miree/tempLoggerNG/hardware/tempLoggerNG-schematic.pdf

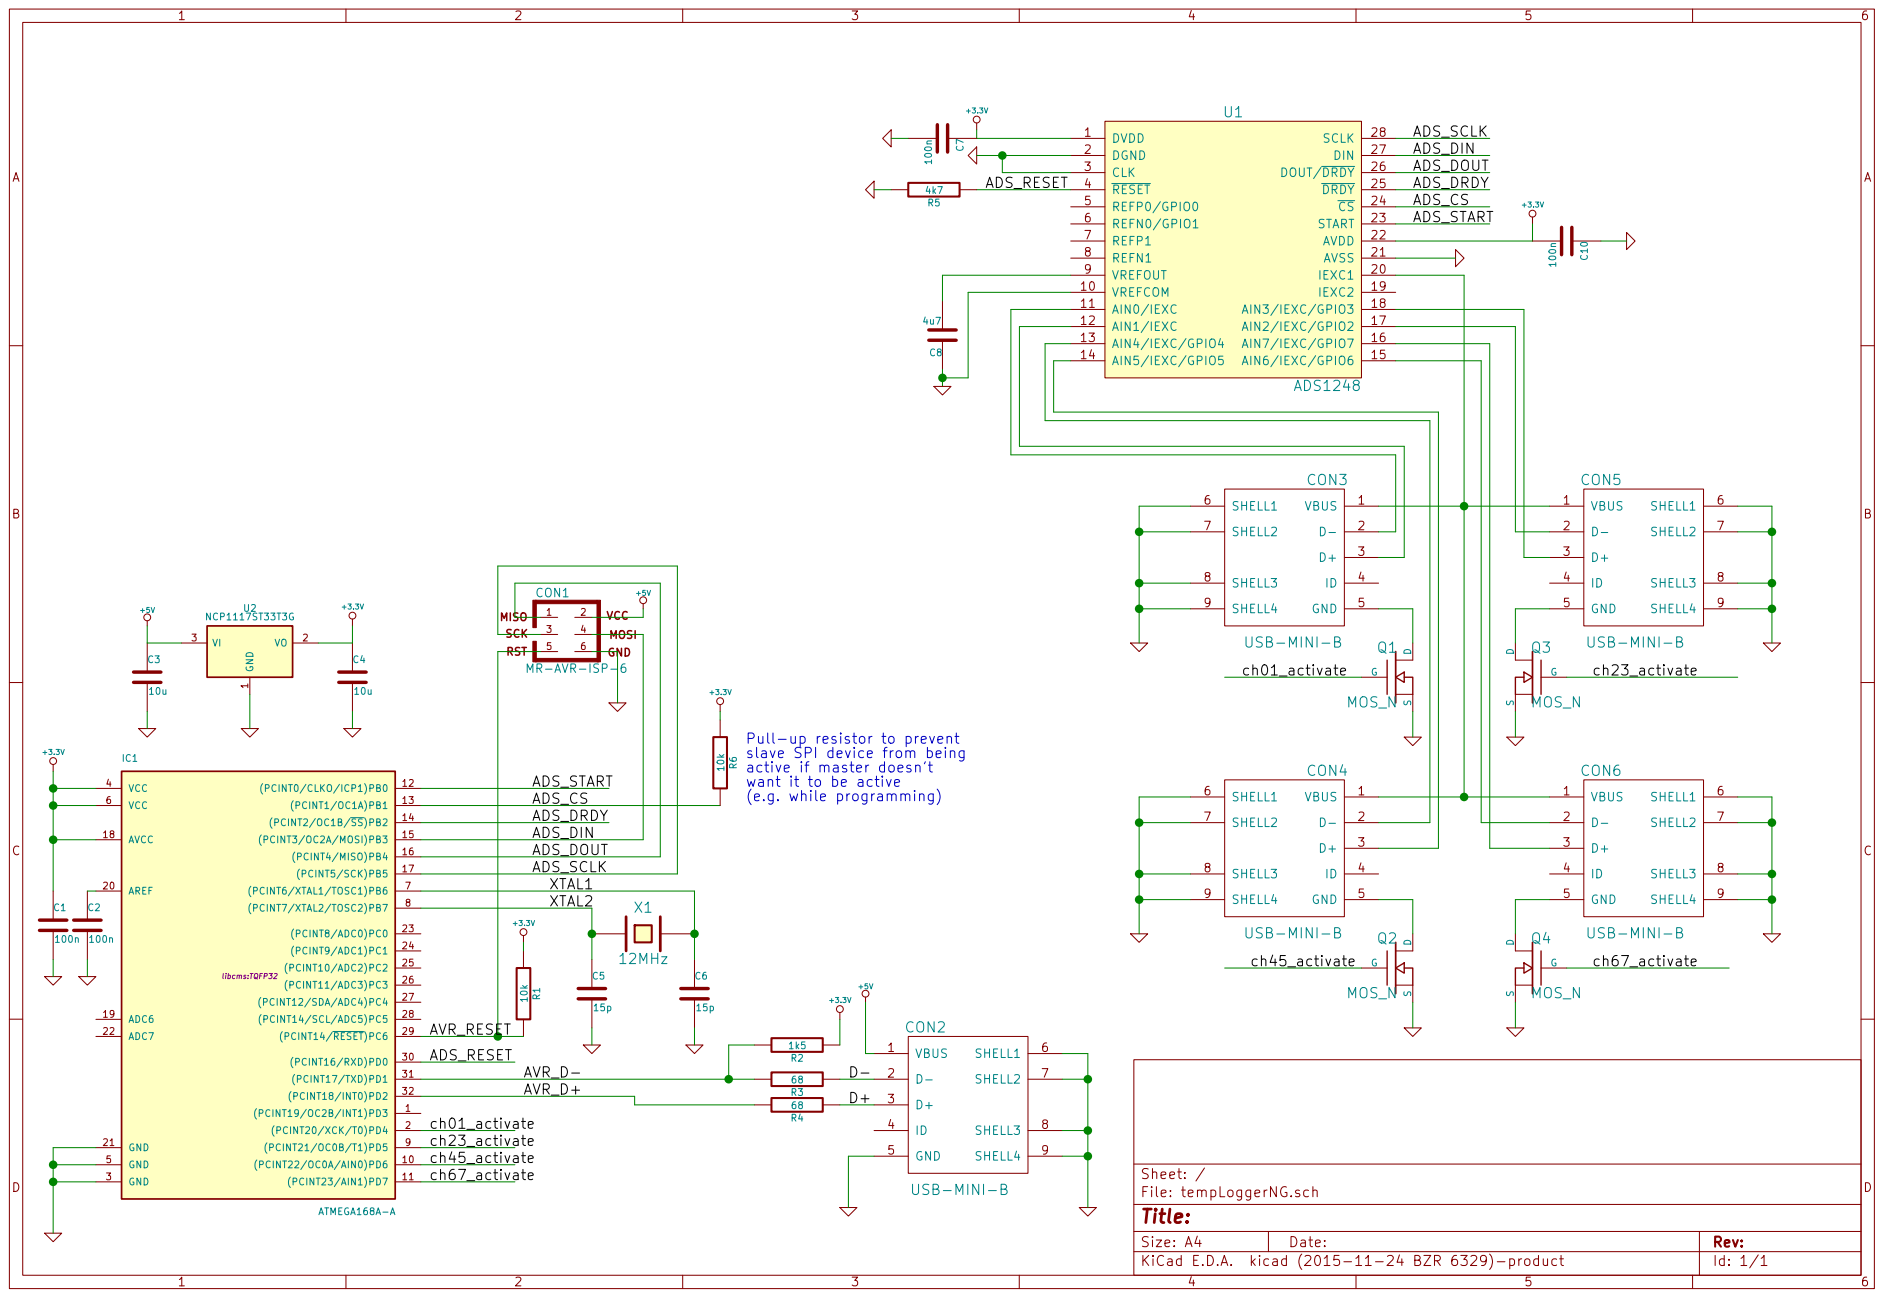
[picture p1: page 1]

slave SPI device from being
active if master doesn't want it to be active (e.g. while programming)

ADS_DRDY
ADS_DIN
ADS_DOUT
ADS_SCLK

File: tempLoggerNG.sch Sheet: /
Id: 1/1 Title:
