miree/tempLoggerNG/(list of files, drawings)

Other design files:
hardware/tempLoggerNG.dsn
