miree/tempLoggerNG/hardware/tempLoggerNG.kicad_pcb

## KiCad design hardware/tempLoggerNG.kicad_pcb (2026-10-11)

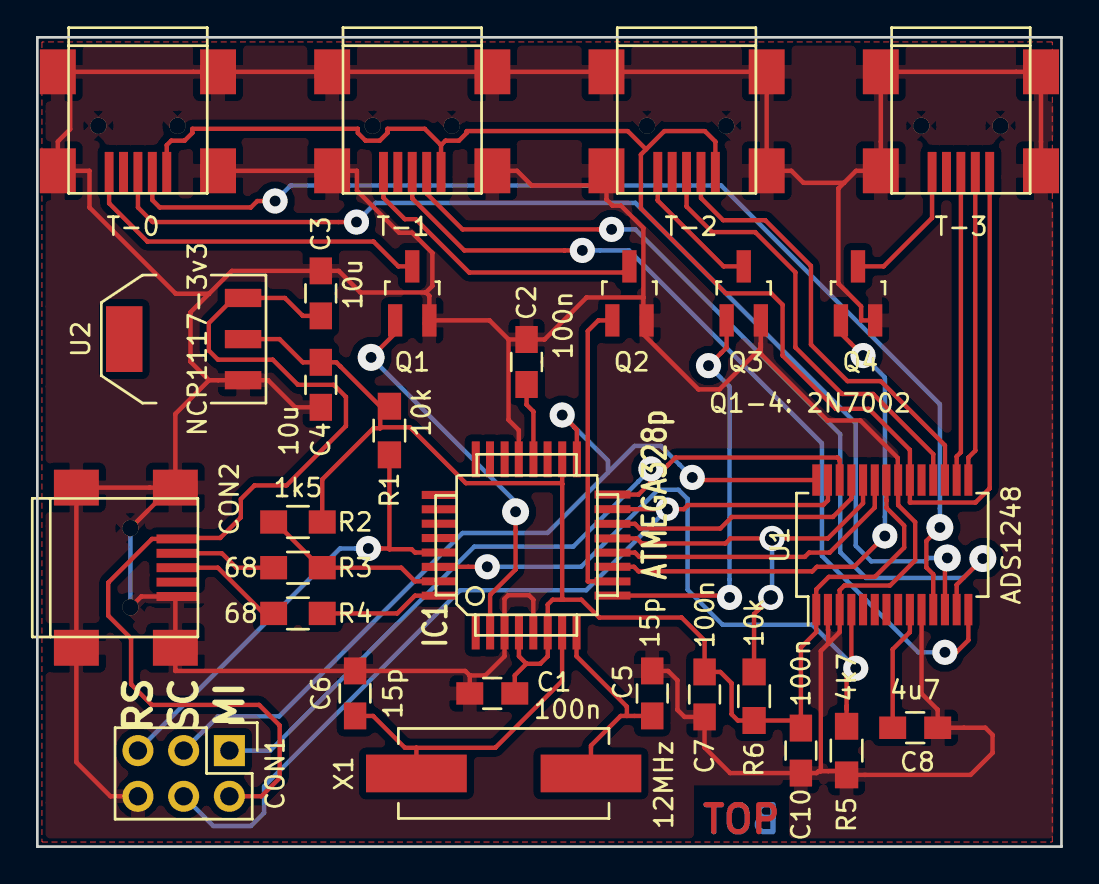
[picture p2: board tempLoggerNG.kicad_pcb from above]

Board: 2 copper layers, 56.9 x 45.0 mm, 29 parts (0 on the bottom side), 36 nets.

Parts:
C1, C2, C7, C10: 100n; C_0805_HandSoldering
C3, C4: 10u; C_0805_HandSoldering
C5, C6: 15p; C_0805_HandSoldering
C8: 4u7; C_0805_HandSoldering
CON1: MR-AVR-ISP-6; Pin_Header_Straight_2x03
CON2: USB-MINI-B; USB_Mini-B
IC1: ATMEGA328p; TQFP32
Q1, Q2, Q3: MOS_N; SOT-23_GSD_Handsoldering
Q4: Q1-4: 2N7002; SOT-23_GSD_Handsoldering
R1, R6: 10k; R_0805_HandSoldering
R2: 1k5; R_0805_HandSoldering
R3, R4: 68; R_0805_HandSoldering
R5: 4k7; R_0805_HandSoldering
T-0, T-1, T-2, T-3: USB-MINI-B; USB_Mini-B
U1: ADS1248; SSOP-28_5.3x10.2mm_Pitch0.65mm
U2: NCP1117-3v3; SOT-223
X1: 12MHz; Crystal_HC49-SD_SMD

Connections:
+3.3V: C1.1, C4.1, C7.1, C10.2, IC1.4, IC1.6, IC1.18, R1.1, R2.1, R6.1, U1.1, U1.22, U2.2
+5V: C3.1, CON1.2, CON2.1, U2.3
/ADS_CS: IC1.13, R6.2, U1.24
/ADS_DIN: CON1.4, IC1.15, U1.27
/ADS_DOUT: CON1.1, IC1.16, U1.26
/ADS_DRDY: IC1.14, U1.25
/ADS_RESET: IC1.30, R5.1, U1.4
/ADS_SCLK: CON1.3, IC1.17, U1.28
/ADS_START: IC1.12, U1.23
/AVR_D+: IC1.32, R4.2
/AVR_D-: IC1.31, R2.2, R3.2
/AVR_RESET: CON1.5, IC1.29, R1.2
/D+: CON2.3, R4.1
/D-: CON2.2, R3.1
/XTAL1: C6.1, IC1.7, X1.2
/XTAL2: C5.1, IC1.8, X1.1
/ch01_activate: IC1.2, Q1.G
/ch23_activate: IC1.9, Q3.G
/ch45_activate: IC1.10, Q2.G
/ch67_activate: IC1.11, Q4.G
GND: C1.2, C2.2, C3.2, C4.2, C5.2, C6.2, C7.2, C8.1, C10.1, CON1.6, CON2.5, CON2.6, CON2.7, CON2.8, CON2.9, IC1.3, IC1.5, IC1.21, Q1.S, Q2.S, Q3.S, Q4.S, R5.2, T-0.6, T-0.7, T-0.8, T-0.9, T-1.6, T-1.7, T-1.8, T-1.9, T-2.6, T-2.7, T-2.8, T-2.9, T-3.6, T-3.7, T-3.8, T-3.9, U1.2, U1.3, U1.10, U1.21, U2.1
unnamed: C2.1, IC1.20
unnamed: C8.2, U1.9
unnamed: T-0.1, T-1.1, T-2.1, T-3.1, U1.20
unnamed: T-0.2, U1.11
unnamed: T-0.3, U1.12
unnamed: Q1.D, T-0.5
unnamed: T-1.2, U1.13
unnamed: T-1.3, U1.14
unnamed: Q2.D, T-1.5
unnamed: T-2.2, U1.17
unnamed: T-2.3, U1.18
unnamed: Q3.D, T-2.5
unnamed: T-3.2, U1.15
unnamed: T-3.3, U1.16
unnamed: Q4.D, T-3.5
