miree/tempLoggerNG/(commit log)

2016-06-30 adding files
    [tempLoggerNG.dsn, tempLoggerNG.kicad_pcb, tempLoggerNG.sch]
2016-06-30 added missing KiCad file
2016-06-30 made copper layers visible
    [tempLoggerNG.kicad_pcb]
2016-06-30 fix warnings in cmopilation of commandline application
    [templogger.c]
2016-06-30 added pdf schematic
2016-07-19 changed product name in error message of commandline tool
    [templogger.c]
2017-07-01 add linear temperature compensation coefficients that are stored in eeprom
2017-07-06 commandline: limit readout rate to 0.15 to be on the safe side
    [tempLoggerNG.sch]
2026-10-11 Expand README with full project description
    Document features, firmware build/flash steps, command-line tool
    usage and calibration procedure, and licensing.
2026-10-11 Recover legacy KiCad symbols and migrate project to KiCad 10 format
    The schematic referenced symbols (GND, R, C, +3.3V, +5V, CRYSTAL, MOS_N,
    USB-MINI-B, NCP1117ST33T3G) from KiCad's pre-2013 default libraries.
    Several of these had previously been rescued into a project-local cache
    by an old KiCad version, but that cache was never committed, so modern
    KiCad (which dropped the legacy libraries entirely) could no longer
    resolve them.
    Recreate the missing symbols in tempLoggerNG-rescue.lib and
    localsymbols.lib using the authentic historical definitions (traced
    through the kicad-library git history), validated against the actual
    wire connections in the schematic. Fix an upstream duplicate-pin-nu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
2026-10-11 Add CERN-OHL-S v2 license for the hardware design
    The firmware and command-line tool stay GPLv2; the KiCad hardware
    design now carries its own open hardware license, matching the
    copyleft spirit of the rest of the project.
